a1zenz/Design-of-Mechanical-Power-Press/(list of files, cad)

Other CAD files:
01.SLDDRW
02.SLDDRW
03.SLDDRW
04.SLDDRW
6.SLDDRW
Final Assembly.SLDDRW
